iorodeo/hv_switching_psu/README.txt

hv_switching_psu:  

Design files for IO Rodeo's 25-100V gel electrophoresis power supply. 

contents:

original - contains design files for original version of the  designs (no display).

with_display - contains design files for the latest version with 0-200V digital display.
