iorodeo/hv_switching_psu/original/hv_switching_psu.pdf

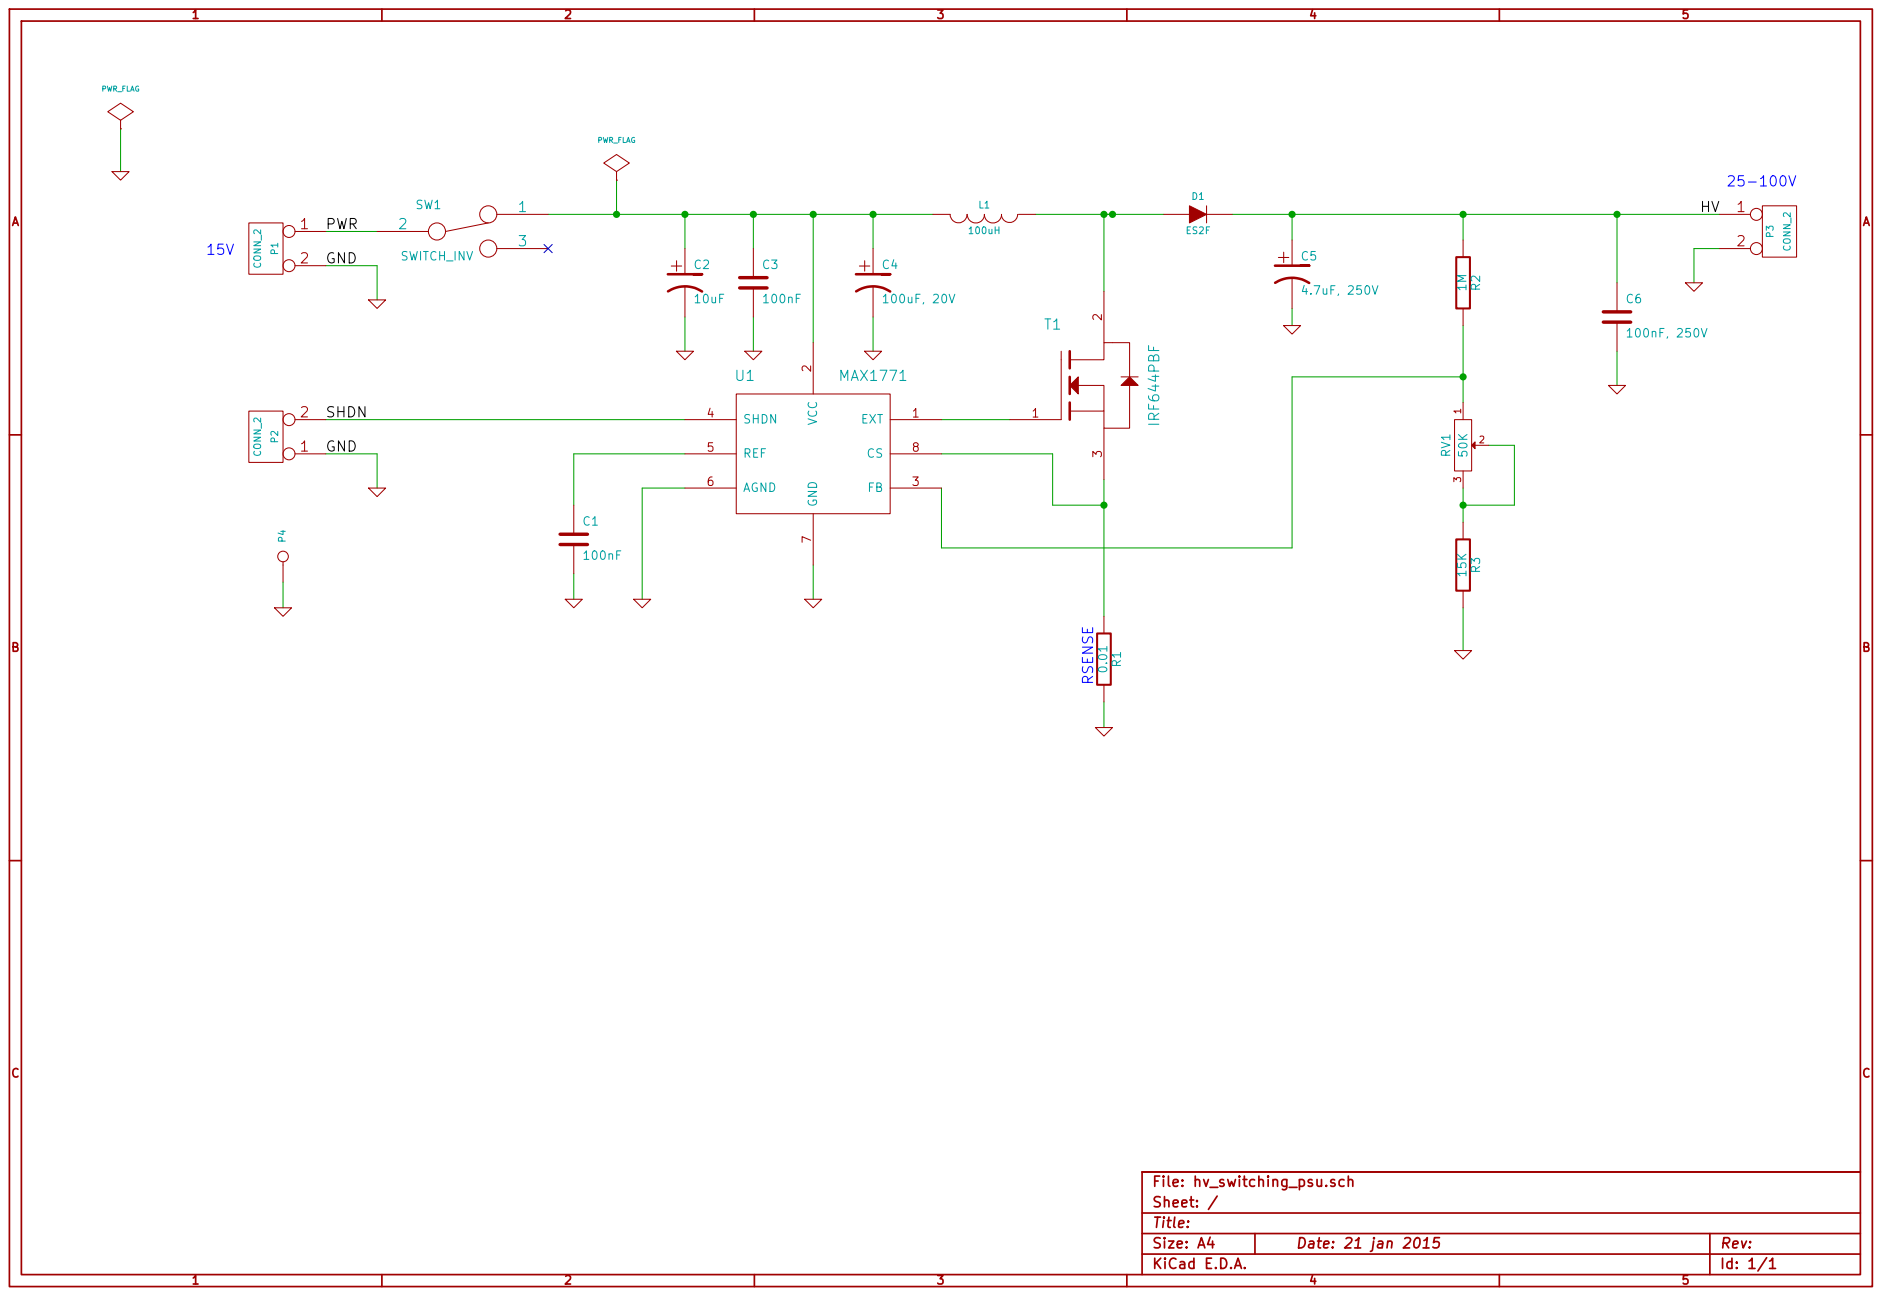
[picture p1: page 1]

2 FB 3 SHDN 4 REF 5 AGND 6 GND

Id: 1/1 Title: File: hv_switching_psu.sch
Sheet: /
