iorodeo/hv_switching_psu/(list of files, drawings)

Other design files:
original/hv_switching_psu.dsn
with_display/hv_switching_psu.dsn
