iorodeo/hv_switching_psu/original/hv_switching_psu.sch

## KiCad design original/hv_switching_psu.sch (2015-01-21)

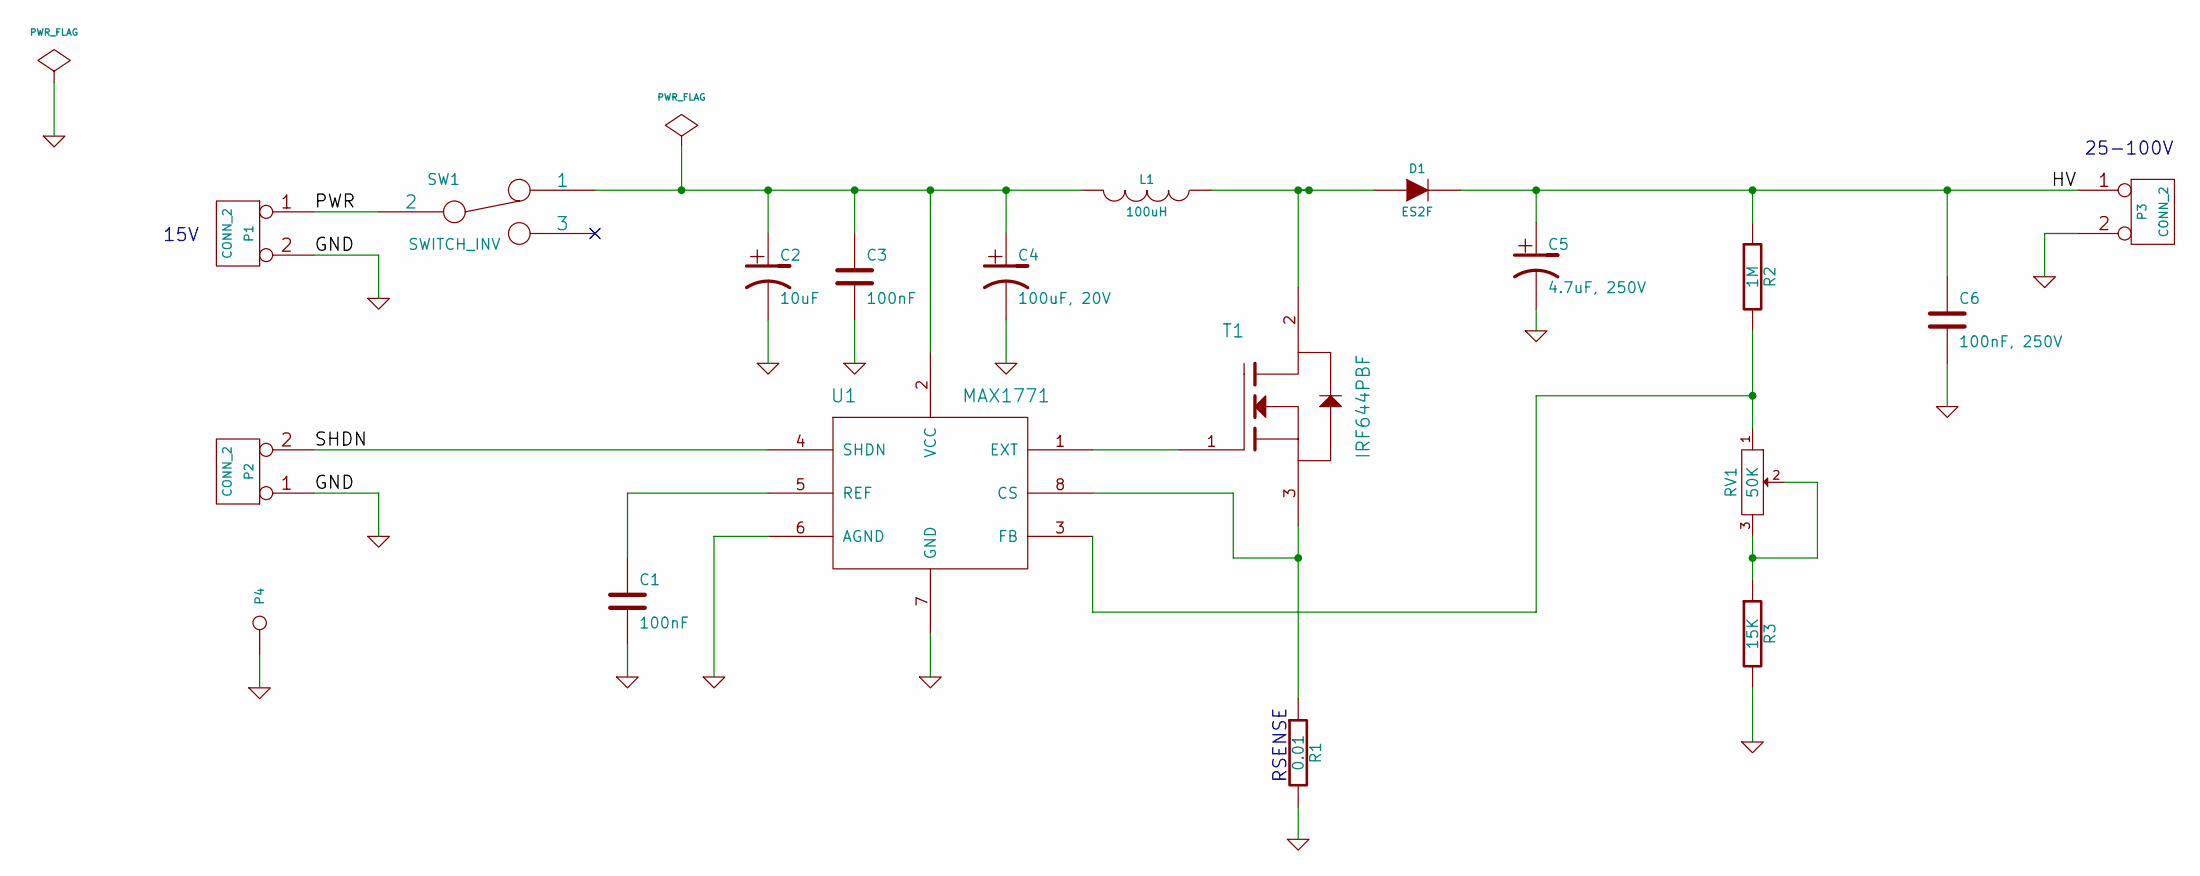
[picture p4: schematic hv_switching_psu.sch]

Parts:
C1, C3: 100nF
C2: 10uF
C4: 100uF, 20V
C5: 4.7uF, 250V
C6: 100nF, 250V
D1: ES2F
L1: 100uH
P1, P2, P3: CONN_2
P4: CONN_1
R1: 0.01
R2: 1M
R3: 15K
RV1: 50K
SW1: SWITCH_INV
T1: IRF644PBF
U1: MAX1771

Connections:
GND: C1.2, C2.2, C3.2, C4.2, C5.2, C6.2, P1.2 (PM), P2.1, P3.2 (PM), P4.1, R1.2, R3.2, U1.6 (AGND), U1.7 (GND)
HV: C5.1, C6.1, D1.2 (K), P3.1, R2.1
unnamed: C1.1, U1.5 (REF)
unnamed: C2.1, C3.1, C4.1, L1.2, SW1.1, U1.2 (VCC)
unnamed: D1.1 (A), L1.1, T1.2
unnamed: R1.1, T1.3, U1.8 (CS)
unnamed: R2.2, RV1.1, U1.3 (FB)
unnamed: R3.1, RV1.2, RV1.3
unnamed: T1.1, U1.1 (EXT)
PWR: P1.1, SW1.2
SHDN: P2.2 (PM), U1.4 (SHDN)

Notes on the sheet:
25-100V
RSENSE
15V
