iorodeo/hv_switching_psu/(commit log)

2012-09-27 Project creation.
    [hv_switching_psu.brd, hv_switching_psu.sch]
2012-09-27 Added banana jacks to BOM.
2013-02-22 Updated design to version 1.1
    [hv_switching_psu-Back.gbl, hv_switching_psu-Front.gtl, hv_switching_psu-Mask_Back.gbs, hv_switching_psu-Mask_Front.gts, hv_switching_psu-PCB_Edges.gbr, hv_switching_psu-SilkS_Back.gbo, hv_switching_psu-SilkS_Front.gto, hv_switching_psu.drl]
2013-04-23 Completed new design.
    [hv_switching_psu.brd, hv_switching_psu.dsn, hv_switching_psu.kicad_pcb, hv_switching_psu.sch]
2013-05-13 Updated BOM.
2013-05-13 Added v1.2 gerber files.
    [hv_switching_psu-B_Mask.gbs, hv_switching_psu-B_SilkS.gbo, hv_switching_psu-Back.gbl, hv_switching_psu-Edge_Cuts.gbr, hv_switching_psu-F_Mask.gts, hv_switching_psu-F_SilkS.gto, hv_switching_psu-Front.gtl, hv_switching_psu.drl]
2013-05-23 Updated bill of materials.
2013-05-23 Minor editing modification to the BOM.
2013-05-23 Minor editing mod of BOM.
2013-05-25 Modified resistor settings.
    [hv_switching_psu.kicad_pcb, hv_switching_psu.sch]
2013-05-25 Save pdf of schematic.
    [hv_switching_psu.sch]
2013-05-25 Added svg of schematic.
2013-05-25 Modified annotations on schematic - changes input and output ranges.
    [hv_switching_psu.sch]
2013-05-25 Added version 1.3 Gerber files.
    [hv_switching_psu-B_Mask.gbs, hv_switching_psu-B_SilkS.gbo, hv_switching_psu-Back.gbl, hv_switching_psu-Edge_Cuts.gbr, hv_switching_psu-F_Mask.gts, hv_switching_psu-F_SilkS.gto, hv_switching_psu-Front.gtl, hv_switching_psu.drl]
2013-05-25 Added gerber_v1p3.zip
2013-05-27 Modified silkscreen, remade v1.3 of gerber files.
    [hv_switching_psu-B_Mask.gbs, hv_switching_psu-B_SilkS.gbo, hv_switching_psu-Back.gbl, hv_switching_psu-Edge_Cuts.gbr, hv_switching_psu-F_Mask.gts, hv_switching_psu-F_SilkS.gto, hv_switching_psu-Front.gtl, hv_switching_psu.drl]
2013-11-20 Changed R3 in BOM.txt from 15k to 10k.
2015-01-21 Added version 1.4 of design - fixed issue with switch.
    [hv_switching_psu.kicad_pcb, hv_switching_psu.sch]
2015-01-21 Added version 1.4 gerver files.
    [hv_switching_psu-B_Mask.gbs, hv_switching_psu-B_SilkS.gbo, hv_switching_psu-Back.gbl, hv_switching_psu-Edge_Cuts.gbr, hv_switching_psu-F_Mask.gts, hv_switching_psu-F_SilkS.gto, hv_switching_psu-Front.gtl, hv_switching_psu.drl]
2015-01-21 Added .zipped version of 1.4 gerbers.
2015-01-21 Minor change to kicad_ pcb.
    [hv_switching_psu.kicad_pcb]
2017-07-12 Updated schematic.
2017-08-05 Added new design with 0-200V display.
    [hv_switching_psu-B_Mask.gbs, hv_switching_psu-B_SilkS.gbo, hv_switching_psu-Back.gbl, hv_switching_psu-Edge_Cuts.gbr, hv_switching_psu-F_Mask.gts, hv_switching_psu-F_SilkS.gto, hv_switching_psu-Front.gtl, hv_switching_psu-Mask_Back.gbs]
2018-12-20 Re-worked layout for psu with display.
    [hv_switching_psu.kicad_pcb]
2018-12-24 Added gerber files for new v1.1 version of design with display.
    [hv_switching_psu-B_Mask.gbs, hv_switching_psu-B_SilkS.gbo, hv_switching_psu-Back.gbl, hv_switching_psu-Edge_Cuts.gbr, hv_switching_psu-F_Mask.gts, hv_switching_psu-F_SilkS.gto, hv_switching_psu-Front.gtl, hv_switching_psu.drl]
2020-11-05 Add missing part to BOM.
